ibuki2003/fuwasdr/board/fuwasdr.kicad_pcb

## KiCad design board/fuwasdr.kicad_pcb (2024-02-28)

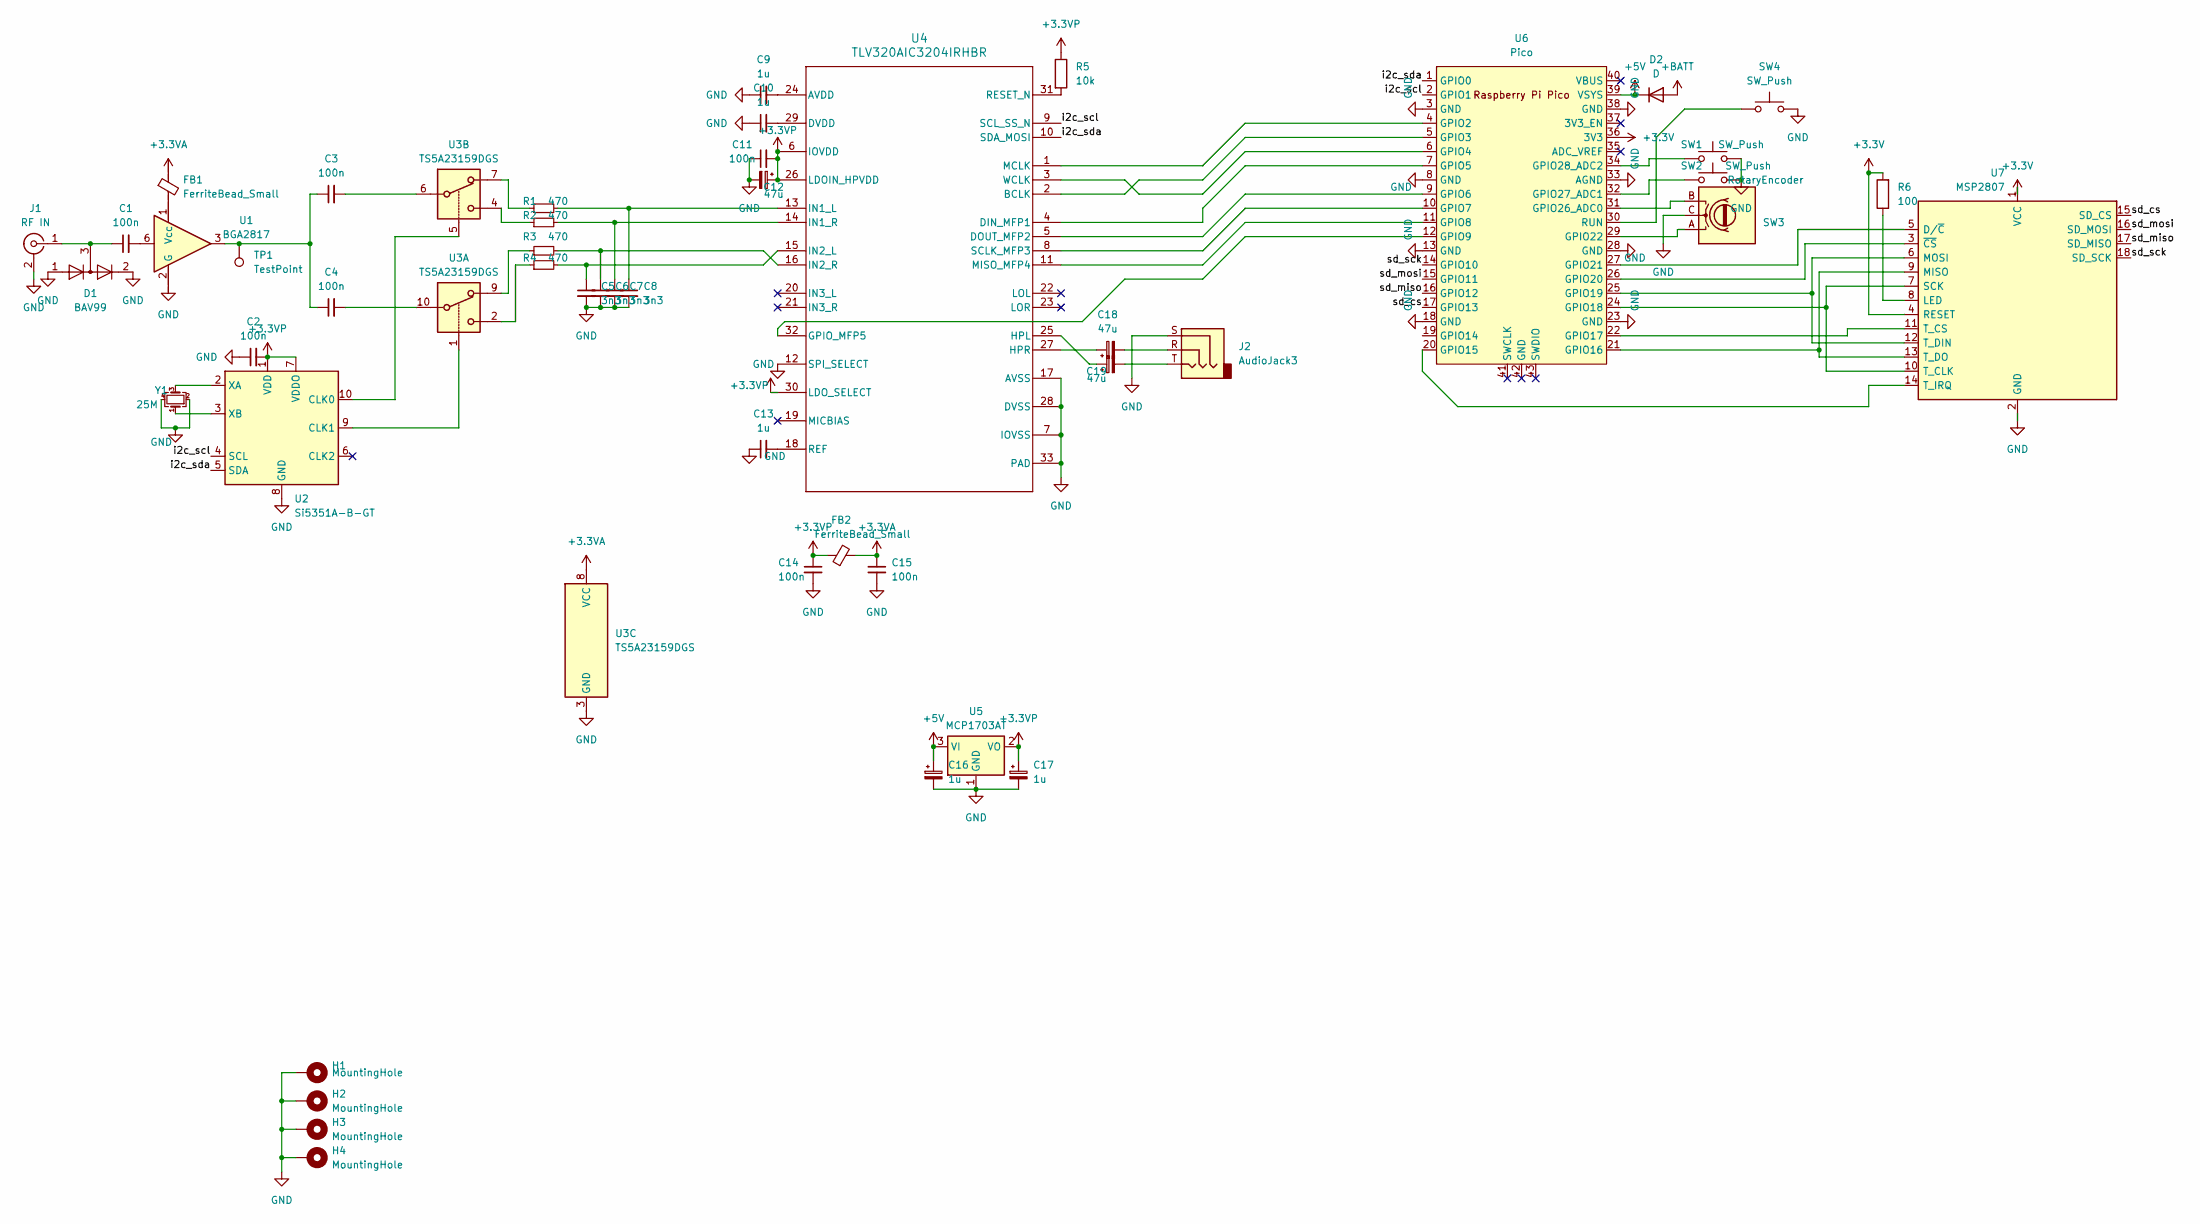
[picture p1: schematic fuwasdr.kicad_sch]

Parts:
C1, C2, C3, C4, C11, C14, C15: 100n; C_0603_1608Metric_Pad1.08x0.95mm_HandSolder
C5, C6, C7, C8: 3n3; C_0603_1608Metric_Pad1.08x0.95mm_HandSolder
C9, C10, C13: 1u; C_0603_1608Metric_Pad1.08x0.95mm_HandSolder
C12: 47u; CP_Radial_D5.0mm_P2.00mm
C16, C17: 1u; CP_Radial_D5.0mm_P2.00mm
C18, C19: 47u; CP_Radial_D6.3mm_P2.50mm
D1: BAV99; SOT-23
D2: D; D_SMA
FB1, FB2: FerriteBead_Small; L_0603_1608Metric_Pad1.05x0.95mm_HandSolder
H1, H2, H3, H4: MountingHole; MountingHole_3.2mm_M3_Pad
J1: RF IN; SMA_Amphenol_901-143_Horizontal
J2: AudioJack3; Jack_3.5mm_Switronic_ST-005-G_horizontal
R1, R2, R3, R4: 470; R_0603_1608Metric_Pad0.98x0.95mm_HandSolder
R5: 10k; R_0603_1608Metric_Pad0.98x0.95mm_HandSolder
R6: 100; R_0603_1608Metric_Pad0.98x0.95mm_HandSolder
SW1, SW2: SW_Push; SW_PUSH_6mm
SW3: RotaryEncoder; RotaryEncoder_Alps_EC12E_Vertical_H20mm
SW4: SW_Push; SW_Push_1P1T_NO_Vertical_Wuerth_434133025816
TP1: TestPoint; TestPoint_Pad_D1.5mm
U1: BGA2817; SOT-363_SC-70-6
U2: Si5351A-B-GT; MSOP-10_3x3mm_P0.5mm
U3: TS5A23159DGS; VSSOP-10_3x3mm_P0.5mm
U4: TLV320AIC3204IRHBR; Texas_S-PVQFN-N32_EP3.45x3.45mm
U5: MCP1703AT; SOT-23
U6: Pico; RPi_Pico_SMD_TH_changed_smd
U7: MSP2807; MSP2807_floating
Y1: 25M; Crystal_SMD_2016-4Pin_2.0x1.6mm

Connections:
+3.3V: R6.2, U6.36 (3V3), U7.1 (VCC), U7.4 (RESET)
+3.3VA: C15.1, FB1.1, FB2.2, U3.8 (VCC)
+3.3VP: C2.2, C11.2, C12.1, C14.1, C17.1, FB2.1, R5.1, U2.1 (VDD), U2.7 (VDDO), U4.6 (IOVDD), U4.26 (LDOIN_HPVDD), U4.30 (LDO_SELECT), U5.2 (VO)
+5V: C16.1, D2.1 (K), U5.3 (VI), U6.39 (VSYS)
+BATT: D2.2 (A)
/i2c_scl: U2.4 (SCL), U4.9 (SCL_SS_N), U6.2 (GPIO1)
/i2c_sda: U2.5 (SDA), U4.10 (SDA_MOSI), U6.1 (GPIO0)
/sd_cs: U6.17 (GPIO13), U7.15 (SD_CS)
/sd_miso: U6.16 (GPIO12), U7.17 (SD_MISO)
/sd_mosi: U6.15 (GPIO11), U7.16 (SD_MOSI)
/sd_sck: U6.14 (GPIO10), U7.18 (SD_SCK)
GND: C2.1, C5.2, C6.2, C7.2, C8.2, C9.1, C10.1, C11.1, C12.2, C13.1, C14.2, C15.2, C16.2, C17.2, D1.1 (K), D1.2 (A), H1.1, H2.1, H3.1, H4.1, J1.2 (Ext), J2.S, SW1.2, SW2.2, SW3.C, SW4.2, U1.2 (G), U1.4 (G), U1.5 (G), U2.8 (GND), U3.3 (GND), U4.7 (IOVSS), U4.12 (SPI_SELECT), U4.17 (AVSS), U4.28 (DVSS), U4.33 (PAD), U5.1 (GND), U6.3 (GND), U6.8 (GND), U6.13 (GND), U6.18 (GND), U6.23 (GND), U6.28 (GND), U6.33 (AGND), U6.38 (GND), U7.2 (GND), Y1.2, Y1.4
unnamed: C1.2, U1.6
unnamed: C3.1, C4.1, TP1.1, U1.3
unnamed: C3.2, U3.6
unnamed: C4.2, U3.10
unnamed: C18.2, J2.R
unnamed: C19.2, J2.T
unnamed: C1.1, D1.3 (K), J1.1 (In)
unnamed: R1.1, U3.7
unnamed: R2.1, U3.4
unnamed: R3.1, U3.9
unnamed: R4.1, U3.2
unnamed: FB1.2, U1.1 (Vcc)
unnamed: U2.10 (CLK0), U3.5
unnamed: U2.9 (CLK1), U3.1
unnamed: U2.2 (XA), Y1.3
unnamed: U2.3 (XB), Y1.1
unnamed: C9.2, U4.24 (AVDD)
unnamed: U4.2 (BCLK), U6.5 (GPIO3)
unnamed: U4.4 (DIN_MFP1), U6.7 (GPIO5)
unnamed: U4.5 (DOUT_MFP2), U6.9 (GPIO6)
unnamed: C10.2, U4.29 (DVDD)
unnamed: U4.32 (GPIO_MFP5), U6.12 (GPIO9)
unnamed: C19.1, U4.25 (HPL)
unnamed: C18.1, U4.27 (HPR)
unnamed: C8.1, R1.2, U4.13 (IN1_L)
unnamed: C7.1, R2.2, U4.14 (IN1_R)
unnamed: C5.1, R4.2, U4.15 (IN2_L)
unnamed: C6.1, R3.2, U4.16 (IN2_R)
unnamed: U4.1 (MCLK), U6.4 (GPIO2)
unnamed: U4.11 (MISO_MFP4), U6.11 (GPIO8)
unnamed: C13.2, U4.18 (REF)
unnamed: R5.2, U4.31 (RESET_N)
unnamed: U4.8 (SCLK_MFP3), U6.10 (GPIO7)
unnamed: U4.3 (WCLK), U6.6 (GPIO4)
unnamed: U6.20 (GPIO15), U7.14 (T_IRQ)
unnamed: U6.21 (GPIO16), U7.9 (MISO), U7.13 (T_DO)
unnamed: U6.22 (GPIO17), U7.11 (T_CS)
unnamed: U6.24 (GPIO18), U7.7 (SCK), U7.10 (T_CLK)
unnamed: U6.25 (GPIO19), U7.6 (MOSI), U7.12 (T_DIN)
unnamed: U6.26 (GPIO20), U7.3 (~CS)
unnamed: U6.27 (GPIO21), U7.5 (D/~C)
unnamed: SW3.A, U6.29 (GPIO22)
unnamed: SW3.B, U6.31 (GPIO26_ADC0)
unnamed: SW2.1, U6.32 (GPIO27_ADC1)
unnamed: SW1.1, U6.34 (GPIO28_ADC2)
unnamed: SW4.1, U6.30 (RUN)
unnamed: R6.1, U7.8 (LED)

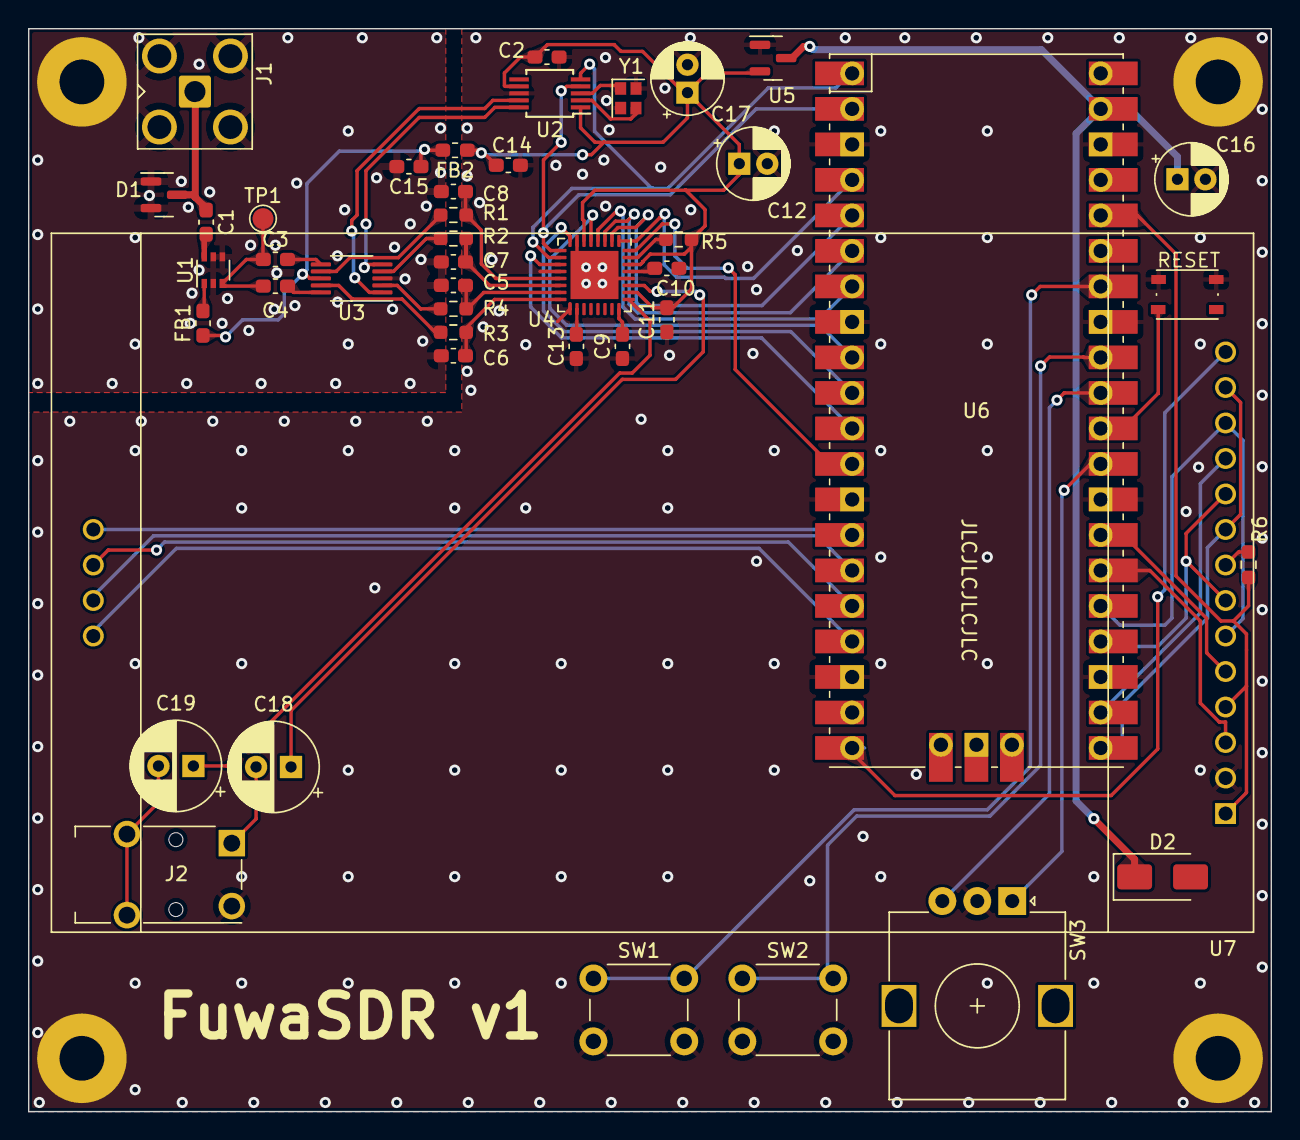
[picture p2: board fuwasdr.kicad_pcb from above]

Board: 2 copper layers, 88.9 x 77.5 mm, 48 parts (0 on the bottom side), 58 nets.
