ibuki2003/fuwasdr/src/core/display.rs

// Screen UI Manager

use crate::display::{lcd::LcdDisplay, text};
use crate::sdr::demod::DemodMethod;

pub struct DispManager {
    lcd: LcdDisplay,

    spectrum_y: u16,
}

impl DispManager {
    const FREQ_X: u16 = 64;
    const FREQ_Y: u16 = 0;
    const TUNE_X: u16 = 224;
    const TUNE_Y: u16 = 24;
    const WF_X: u16 = 32;
    const WF_Y: u16 = 64;

    const OPTS_X: u16 = 282;
    const ADCGAIN_Y: u16 = 0;
    const VOL_Y: u16 = 10;
    const METHOD_Y: u16 = 20;

    pub fn new(lcd: LcdDisplay) -> Self {
        Self { lcd, spectrum_y: 0 }
    }

    pub fn init(&mut self) {
        self.lcd.init();
    }

    pub fn draw_text(&mut self, text: &[u8], x: u16, y: u16) {
        let renderer = text::TextRendererEN::new(text);
        let size = renderer.size();
        self.lcd.set_window(x, y, size.0, size.1);
        self.lcd.send_data_iter(renderer);
    }

    pub fn draw_text_small(&mut self, text: &[u8], x: u16, y: u16) {
        let renderer = text::TextRendererMisakiEn::new(text);
        let size = renderer.size();
        self.lcd.set_window(x, y, size.0, size.1);
        self.lcd.send_data_iter(renderer);
    }

    pub fn draw_text_misaki(&mut self, text: &[u16], x: u16, y: u16) {
        let renderer = text::MisakiTextRender::new(text);
        let size = renderer.size();
        self.lcd.set_window(x, y, size.0, size.1);
        self.lcd.send_data_iter(renderer);
    }

    pub fn draw_freq(&mut self, freq: u32) {
        let mut buf = [0u8; 9];

        uint_to_string(freq, &mut buf);

        for i in 0..3 {
            self.draw_text(
                &buf[i * 3..i * 3 + 3],
                Self::FREQ_X + (16 * 3 + 8) * i as u16,
                Self::FREQ_Y,
            );
        }

        // waterfall
        // interval = 100kHz
        // in screen = 133px

        self.lcd
            .set_window(0, Self::WF_Y - 16, LcdDisplay::LCD_WIDTH, 16);

        self.lcd
            .send_data_iter(core::iter::repeat(0x00).take(LcdDisplay::LCD_WIDTH as usize * 8 * 2));
        let x = Self::WF_X + 128 - (freq % 10_000 * 256 / 192000) as u16 - 120;

        for _ in 0..8 {
            for _ in 0..Self::WF_X {
                self.lcd.send_data_unchecked(&[0, 0]);
            }
            for i in Self::WF_X..Self::WF_X + 256 {
                if i >= x && (i - x) * 3 % 40 < 3 {
                    self.lcd.send_data_unchecked(&[0xff, 0xff]);
                } else {
                    self.lcd.send_data_unchecked(&[0, 0]);
                }
            }
            for _ in 0..Self::WF_X {
                self.lcd.send_data_unchecked(&[0, 0]);
            }
        }

        buf[6] = b'M';
        let mut f = (freq - 96_000 + 100_000 - 1) / 100_000;
        let mut x =
            (Self::WF_X as i32 + 128 + ((f * 100_000) as i32 - freq as i32) * 256 / 192000) as u16;
        while f * 100_000 < freq + 96_000 {
            let i = uint_to_string(f, &mut buf[..5]);
            buf[5] = buf[4];
            buf[4] = b'.';

            self.draw_text_small(&buf[i..7], x + 1 - (4 - i) as u16 * 8, Self::WF_Y - 16);

            f += 1;
            x += 133;
        }
    }

    pub fn draw_demod_freq(&mut self, freq: i32) {
        let x = 160_u16.wrapping_add_signed((freq / 750) as i16);

        self.lcd
            .set_window(0, Self::WF_Y - 24, LcdDisplay::LCD_WIDTH, 8);
        self.lcd.send_data(&[]); // dummy
        for j in (0..8).rev() {
            for i in 0..LcdDisplay::LCD_WIDTH {
                if i.abs_diff(x) <= j / 2 {
                    self.lcd.send_data_unchecked(&[0xff, 0xff]);
                } else {
                    self.lcd.send_data_unchecked(&[0, 0]);
                }
            }
        }

        let mut buf = [0u8; 6];
        int_to_string(freq, &mut buf);
        self.draw_text_small(&buf, Self::TUNE_X, Self::TUNE_Y);
    }

    pub fn draw_adc_gain(&mut self, gain: i8) {
        let mut buf = [0u8; 4];
        int_to_string(gain as i32, &mut buf);
        self.draw_text_small(&buf, Self::OPTS_X, Self::ADCGAIN_Y);
    }

    pub fn draw_volume(&mut self, volume: i16) {
        let mut buf = [0u8; 4];
        int_to_string(volume as i32, &mut buf);
        self.draw_text_small(&buf, Self::OPTS_X, Self::VOL_Y);
    }

    pub fn draw_method(&mut self, method: DemodMethod) {
        let t = match method {
            DemodMethod::AM => b"AM",
            DemodMethod::FM => b"FM",
        };
        self.draw_text_small(t, Self::OPTS_X, Self::METHOD_Y);
    }

    /*
    cursor pos:
    0-3: demod tune (10Hz ~ 10kHz)
    4-12: tune
    13: adc gain
    14: volume
    15: method
    */
    pub fn draw_cursor(&mut self, cursor: u8) {
        // tune digit
        self.lcd
            .set_window(Self::FREQ_X, Self::FREQ_Y + 32, 16 * 9 + 8 * 3, 1);
        for i in (0..9).rev() {
            self.lcd.send_data_iter(
                core::iter::repeat(if i == cursor - 4 { 0xff } else { 0x00 }).take(16 * 2),
            );

            if i % 3 == 0 {
                self.lcd
                    .send_data_iter(core::iter::repeat(0x00).take(8 * 2));
            }
        }

        // demod tune digit
        self.lcd
            .set_window(Self::TUNE_X + 8, Self::TUNE_Y + 8, 8 * 4, 1);
        for i in (0..4).rev() {
            self.lcd.send_data_iter(
                core::iter::repeat(if i == cursor { 0xff } else { 0x00 }).take(8 * 2),
            );
        }

        self.lcd.set_window(Self::OPTS_X - 1, 0, 1, 40);
        for i in 13..16 {
            self.lcd.send_data_iter(
                core::iter::repeat(if cursor == i { 0xff } else { 0x00 }).take(10 * 2),
            );
        }
    }

    pub fn draw_spectrum(&mut self, data: &[crate::dsp::DSPComplex]) {
        self.lcd.set_window(
            Self::WF_X,
            self.spectrum_y + Self::WF_Y,
            data.len() as u16,
            1,
        );
        for d in data {
            let re = (d.re.0 >> 3).min(255).unsigned_abs();
            let im = (d.im.0 >> 3).min(255).unsigned_abs();
            let v = re * re + im * im;
            // let v = 31 | (re.min(31) << 6) | (im.min(31) << 11);
            let v = colormap(v);
            self.lcd.send_data(&v.to_be_bytes());
        }
        self.spectrum_y += 1;
        if self.spectrum_y >= LcdDisplay::LCD_HEIGHT - Self::WF_Y {
            self.spectrum_y = 0;
        }
    }
}

fn uint_to_string(mut v: u32, buf: &mut [u8]) -> usize {
    for i in (0..buf.len()).rev() {
        buf[i] = (v % 10) as u8 + b'0';
        v /= 10;
        if v == 0 {
            // break;
            return i;
        }
    }
    0
}

fn int_to_string(v: i32, buf: &mut [u8]) -> usize {
    buf[0] = if v < 0 { b'-' } else { b'+' };
    uint_to_string(v.unsigned_abs(), &mut buf[1..]) + 1
}

// map from 0..=65535
fn colormap(v: u16) -> u16 {
    let mut vv = v;
    let mut d = 0;
    if vv < (1<<8) { d |= 8; vv <<= 8; }
    if vv < (1<<12) { d |= 4; vv <<= 4; }
    if vv < (1<<14) { d |= 2; vv <<= 2; }
    if vv < (1<<15) { d |= 1; vv <<= 1; }
    d = 15 - d;

    // logarighmic scale
    let v = (d << 12) | (vv >> 4);
    match v {
        0..=16383 => v >> 9,
        16384..=49151 => ((v - 16384) >> 4) | 31,
        49152..=65535 => ((v - 49152) << 2) | 2047,
    }
}
