ibuki2003/fuwasdr/(commit log)

2024-02-07 feat: board pins
2024-02-10 refactor: rename module pins to board
2024-02-12 feat: use static shared i2c bus
2024-02-13 build: usb-device and usbd-audio
2024-02-13 feat: lcd reset for pin 14
    [board.rs]
2024-02-14 feat: rotary encoder input
2024-02-15 fix: quadrature phase swap
    [clockctl.rs]
2024-02-17 refactor: use bsp_pins! for pin type manage
2024-02-17 fix: add display module
    [manager.rs, text.rs]
2024-02-18 feat: button controll
2024-02-19 feat: use DMA
2024-02-27 feat: interrupt approach
2024-02-28 chore: add board
    [fuwasdr.kicad_pcb, fuwasdr.kicad_sch]
2024-03-11 feat: adc DC cut
2024-03-27 fix: remove unused import
    [codec.rs]
